Reefwing-Software/Force-Sensing-Resistor-Arduino-Shield/bom/BOM_PCB_FSR Amplifier_2023-05-21.csv

Item # | Designator | Qty | Part # | Description/Value | Unit (AUD) | Ext (AUD) | URL
1 | C1 | 1 | RC5320 | 47pF | $0.19 | $0.19 | https://www.jaycar.com.au/47pf-50vdc-ceramic-capacitors-pack-of-2/p/RC5320
2 | C2 | 1 | RZ6628 | 1uF, 35VDC | $0.75 | $0.75 | https://www.jaycar.com.au/1uf-35vdc-tantalum-capacitor/p/RZ6628
3 | J1,J2 | 2 | HM3172 | Screw Terminal | $1.55 | $3.10 | https://www.jaycar.com.au/2-way-pcb-mount-screw-terminals-5mm-pitch/p/HM3172
4 | LED1,LED2 | 2 | ZD0150 | LED_5MM | $0.40 | $0.80 | https://www.jaycar.com.au/red-5mm-led-8mcd-round-diffused/p/ZD0150
5 | R1,R5 | 2 | RR0596 | 10K, 0.5W | $0.11 | $0.21 | https://www.jaycar.com.au/10k-ohm-0-5-watt-metal-film-resistors-pack-of-8/p/RR0596
6 | R2,R3 | 2 | RR0552 | 150R, 0.5W | $0.11 | $0.21 | https://www.jaycar.com.au/150-ohm-0-5-watt-metal-film-resistors-pack-of-8/p/RR0552
7 | R4 | 1 | RR0560 | 330R | $0.11 | $0.11 | https://www.jaycar.com.au/330-ohm-0-5-watt-metal-film-resistors-pack-of-8/p/RR0560
8 | SW1 | 1 | SP0609 | SPST Switch, 12VDC | $1.50 | $1.50 | https://www.jaycar.com.au/spst-pcb-mount-tactile-switch-round/p/SP0609
9 | U1 | 1 | RP8518 | 100K POT - GAIN | $4.95 | $4.95 | https://www.jaycar.com.au/100k-ohm-linear-b-single-gang-9mm-potentiometer/p/RP8518
10 | U2 | 1 | ZL3358 | AS358 / LM358 | $0.31 | $0.31 | https://www.jaycar.com.au/lm358-low-power-dual-op-amp-linear-ic/p/ZL3358
11 | U3 | 1 | HM3212 | 40 x 0.1" Pin Headers | $1.45 | $1.45 | https://www.jaycar.com.au/40-pin-header-terminal-strip/p/HM3212
 |  |  |  |  |  | $13.58
