Reefwing-Software/Force-Sensing-Resistor-Arduino-Shield/schematic/Schematic_FSR Amplifier_2023-05-21.pdf

# ADC0 ADC1

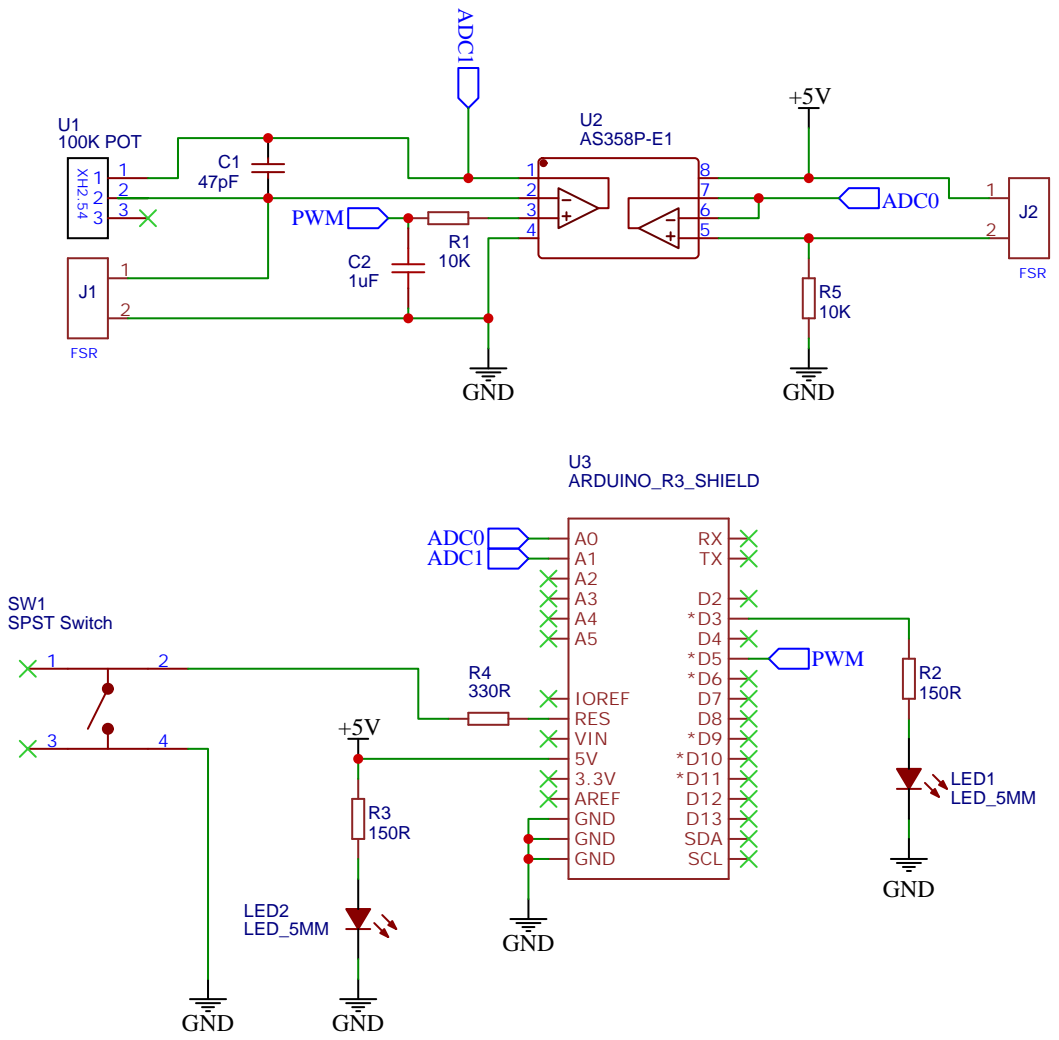
[picture p1: page 1]

Drawn By: David Such
