Reefwing-Software/Force-Sensing-Resistor-Arduino-Shield/(list of files, drawings)

Other design files:
easyeda/PCB_PCB_FSR Amplifier_2023-05-21.json
easyeda/SCH_FSR Amplifier_2023-05-21.json
