Reefwing-Software/Force-Sensing-Resistor-Arduino-Shield/(commit log)

2023-05-21 Original Release
    [PCB_PCB_FSR Amplifier_2023-05-21.json, SCH_FSR Amplifier_2023-05-21.json]
2023-05-21 Added BOM and EasyEDA files
    [BOM_PCB_FSR Amplifier_2023-05-21.csv, PCB_PCB_FSR Amplifier_2023-05-21.json, SCH_FSR Amplifier_2023-05-21.json]
