Reefwing-Software/Force-Sensing-Resistor-Arduino-Shield/(notices)

Notices in the files:
README.md:
License: MIT
